nickbild/fpga_vga/media/pixel_numbering2.png

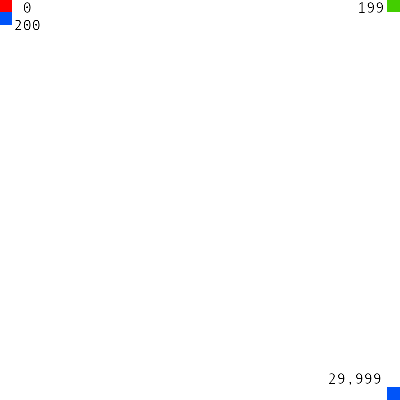
media/pixel_numbering2.png
