nickbild/fpga_vga/top.v

`timescale 1ns/1ps

module top (
    // 16MHz clock
    input CLK,

    // USB pull-up resistor
    output USBPU,

    // GPIO Outputs.
    output PIN_8,
    output PIN_9,
    output PIN_10,
    // output PIN_11,  Pin looks to be dead.
    output PIN_12,
    output PIN_13,

    // GPIO Inputs.
    input PIN_1,
    input PIN_2,
    input PIN_3,
    input PIN_4,
    input PIN_5,
    input PIN_6,
    input PIN_7,
    input PIN_14,
    input PIN_15,
    input PIN_16,
    input PIN_17,
    input PIN_18,
    input PIN_19,
    input PIN_20,
    input PIN_21,
    input PIN_22,
    input PIN_23,
    input PIN_24,
    input PIN_31
);

    // drive USB pull-up resistor to '0' to disable USB
    assign USBPU = 0;

    // VGA output signals.
    wire clk_20mhz;
    assign PIN_8 = red;
    assign PIN_9 = green;
    assign PIN_10 = blue;
    assign PIN_12 = h_sync;
    assign PIN_13 = v_sync;

    reg [8:0] h_counter;
    reg [0:0] h_sync;

    reg [9:0] v_counter;
    reg [0:0] v_sync;

    reg [0:0] red;
    reg [0:0] green;
    reg [0:0] blue;

    // Interrupt input.
    wire interrupt;
    assign interrupt = PIN_31;

    // Address inputs.
    wire a0;
    wire a1;
    wire a2;
    wire a3;
    wire a4;
    wire a5;
    wire a6;
    wire a7;
    wire a8;
    wire a9;
    wire a10;
    wire a11;
    wire a12;
    wire a13;
    wire a14;

    assign a0 = PIN_1;
    assign a1 = PIN_2;
    assign a2 = PIN_3;
    assign a3 = PIN_4;
    assign a4 = PIN_5;
    assign a5 = PIN_6;
    assign a6 = PIN_7;
    assign a7 = PIN_14;
    assign a8 = PIN_15;
    assign a9 = PIN_16;
    assign a10 = PIN_17;
    assign a11 = PIN_18;
    assign a12 = PIN_19;
    assign a13 = PIN_20;
    assign a14 = PIN_21;

    // RGB data inputs.
    wire r_in;
    wire g_in;
    wire b_in;

    assign r_in = PIN_22;
    assign g_in = PIN_23;
    assign b_in = PIN_24;

    // BRAM
    reg [15:0] memory_data_in;  // bits: 13, 9, 5, 1
    reg [14:0] w_absolute_addr;
    reg [10:0] waddr;

    reg [14:0] absolute_addr;
    wire [10:0] raddr;
    assign raddr = {1'b0, absolute_addr[9:0]};
    reg display;

    reg write_en1;
    reg write_en2;
    reg write_en3;
    reg write_en4;
    reg write_en5;
    reg write_en6;
    reg write_en7;
    reg write_en8;
    reg write_en9;
    reg write_en10;
    reg write_en11;
    reg write_en12;
    reg write_en13;
    reg write_en14;
    reg write_en15;
    reg write_en16;
    reg write_en17;
    reg write_en18;
    reg write_en19;
    reg write_en20;
    reg write_en21;
    reg write_en22;
    reg write_en23;
    reg write_en24;
    reg write_en25;
    reg write_en26;
    reg write_en27;
    reg write_en28;
    reg write_en29;
    reg write_en30;

    wire [15:0] memory_data_out_1;
    wire [15:0] memory_data_out_2;
    wire [15:0] memory_data_out_3;
    wire [15:0] memory_data_out_4;
    wire [15:0] memory_data_out_5;
    wire [15:0] memory_data_out_6;
    wire [15:0] memory_data_out_7;
    wire [15:0] memory_data_out_8;
    wire [15:0] memory_data_out_9;
    wire [15:0] memory_data_out_10;
    wire [15:0] memory_data_out_11;
    wire [15:0] memory_data_out_12;
    wire [15:0] memory_data_out_13;
    wire [15:0] memory_data_out_14;
    wire [15:0] memory_data_out_15;
    wire [15:0] memory_data_out_16;
    wire [15:0] memory_data_out_17;
    wire [15:0] memory_data_out_18;
    wire [15:0] memory_data_out_19;
    wire [15:0] memory_data_out_20;
    wire [15:0] memory_data_out_21;
    wire [15:0] memory_data_out_22;
    wire [15:0] memory_data_out_23;
    wire [15:0] memory_data_out_24;
    wire [15:0] memory_data_out_25;
    wire [15:0] memory_data_out_26;
    wire [15:0] memory_data_out_27;
    wire [15:0] memory_data_out_28;
    wire [15:0] memory_data_out_29;
    wire [15:0] memory_data_out_30;

    // Create a 10MHz clock.
    // http://martin.hinner.info/vga/timing.html
    // 40 MHz = 800x600@60Hz
    // 10 MHz = 200x150
    SB_PLL40_CORE #(
      .DIVR(0),
      .DIVF(19),
      .DIVQ(4),
      .FILTER_RANGE(3'b001),
      .FEEDBACK_PATH("SIMPLE"),
      .DELAY_ADJUSTMENT_MODE_FEEDBACK("FIXED"),
      .FDA_FEEDBACK(4'b0000),
      .DELAY_ADJUSTMENT_MODE_RELATIVE("FIXED"),
      .FDA_RELATIVE(4'b0000),
      .SHIFTREG_DIV_MODE(2'b00),
      .PLLOUT_SELECT("GENCLK"),
      .ENABLE_ICEGATE(1'b0)
    ) pll (
      .REFERENCECLK(CLK),
      .PLLOUTCORE(clk_20mhz),
      .RESETB(1'b1),
      .BYPASS(1'b0)
    );

    initial begin
      h_counter <= 0;
      v_counter <= 0;

      h_sync <= 0;
      v_sync <= 0;
      red <= 0;
      green <= 0;
      blue <= 0;
    end

    always @(posedge clk_20mhz) begin
      if (display) begin  // Slow down clock for display.
        // Horitonal sync.
        if (h_counter > 210 && h_counter < 242)
        begin
          h_sync <= 1;
        end else begin
          h_sync <= 0;
        end

        // Vertical sync.
        if (v_counter > 600 && v_counter < 605)
        begin
          v_sync <= 1;
        end else begin
          v_sync <= 0;
        end

        // Display pixel.
        if (h_counter > 199 || v_counter > 599)  // Horizontal/vertical blanking.
      	begin
      	  red <= 0;
          green <= 0;
          blue <= 0;
      	end else // Active video.
        begin
          if (absolute_addr > 29695) begin
            red <= memory_data_out_30[1];
            green <= memory_data_out_30[5];
            blue <= memory_data_out_30[9];
          end else if (absolute_addr > 28671) begin
            red <= memory_data_out_29[1];
            green <= memory_data_out_29[5];
            blue <= memory_data_out_29[9];
          end else if (absolute_addr > 27647) begin
            red <= memory_data_out_28[1];
            green <= memory_data_out_28[5];
            blue <= memory_data_out_28[9];
          end else if (absolute_addr > 26623) begin
            red <= memory_data_out_27[1];
            green <= memory_data_out_27[5];
            blue <= memory_data_out_27[9];
          end else if (absolute_addr > 25599) begin
            red <= memory_data_out_26[1];
            green <= memory_data_out_26[5];
            blue <= memory_data_out_26[9];
          end else if (absolute_addr > 24575) begin
            red <= memory_data_out_25[1];
            green <= memory_data_out_25[5];
            blue <= memory_data_out_25[9];
          end else if (absolute_addr > 23551) begin
            red <= memory_data_out_24[1];
            green <= memory_data_out_24[5];
            blue <= memory_data_out_24[9];
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
    ) ram22 (
      .RDATA(memory_data_out_22),
      .RADDR(raddr),
      .WADDR(waddr),
      .WDATA(memory_data_in),
      .RCLKE(1'b1),
      .RCLK(clk_20mhz),
      .RE(1'b1),
      .WCLKE(1'b1),
      .WCLK(clk_20mhz),
      .WE(write_en22)
    );
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
