nickbild/fpga_vga/(commit log)

2020-06-01 Basic 200x150@60Hz generator working.
2020-06-06 Switch pins.
2020-06-19 Fix write timing issue.
    [top.v]
2020-06-19 Fix off by one pixel glitch.
    [top.v]
2020-06-19 Reformat and correct horiz. pixel range.
    [top.v]
2020-06-20 Arduino driver code.
